codermery/OpenPLC-with-julide/(commit log)

2026-05-29 Migrate HTTP communication to Modbus TCP for OpenPLC gate controller
    [VARIABLES.csv]
2026-05-29 Add comprehensive Turkish README and finalize Modbus TCP firmware
    - README.md rewritten from scratch: full system architecture, hardware
    pin maps, OpenPLC Ladder state machine, verified Modbus coil map (0-12),
    servo PWM patch explanation, troubleshooting (10 issues), setup steps,
    test procedure, and lessons learned
    - Remove Arduino-ide/openPLC.ino (HTTP-based, superseded by Modbus TCP)
    - Arduino-ide/julide.ino: raw Modbus TCP client, gate request/passed flow,
    HC-SR04 distance-based slowdown/stop, web joystick HTTP server
    [julide.ino]
2026-06-11 Finalize JULIDE robot and gate controller with safety and config improvements.
    Add EEPROM-backed PLC IP and web safety settings, motor braking and direction fixes on JULIDE, consolidate gate PWM logic, and include the project delivery report.
    [VARIABLES.csv]
